Adil-Jussupov/Rheometer/Random files/IMG_4448.jpg

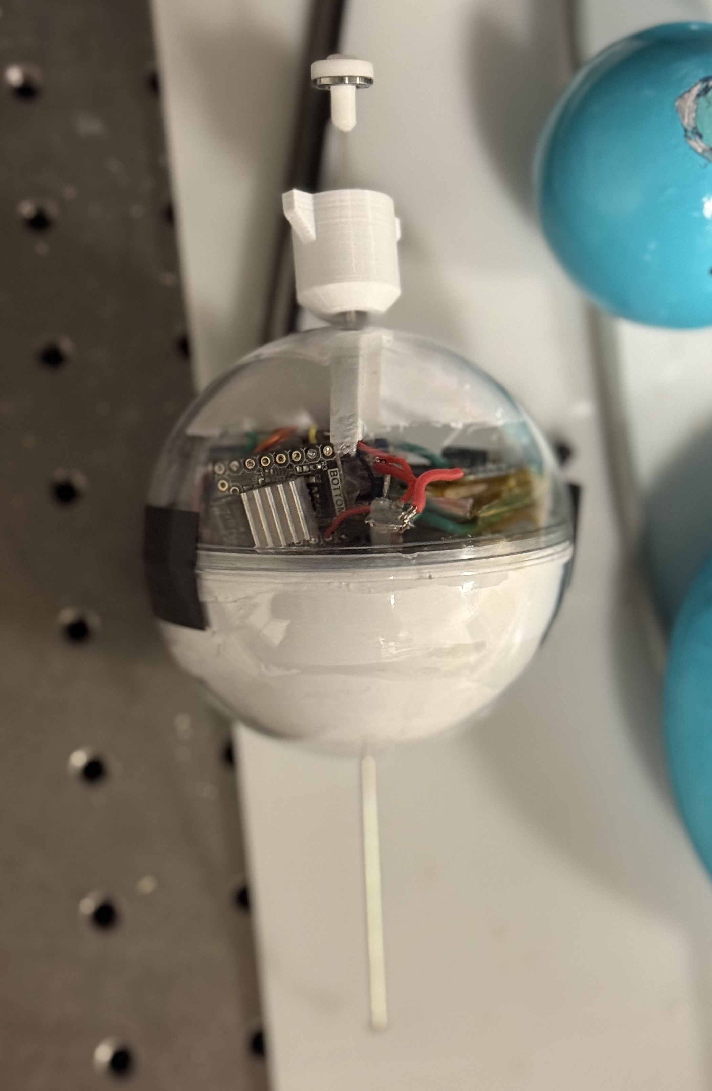
Random files/IMG_4448.jpg
