Adil-Jussupov/Rheometer/README.md

# Rheometer
Floating robot for measuring liquid properties
