Adil-Jussupov/Rheometer/LoadCell.pdf

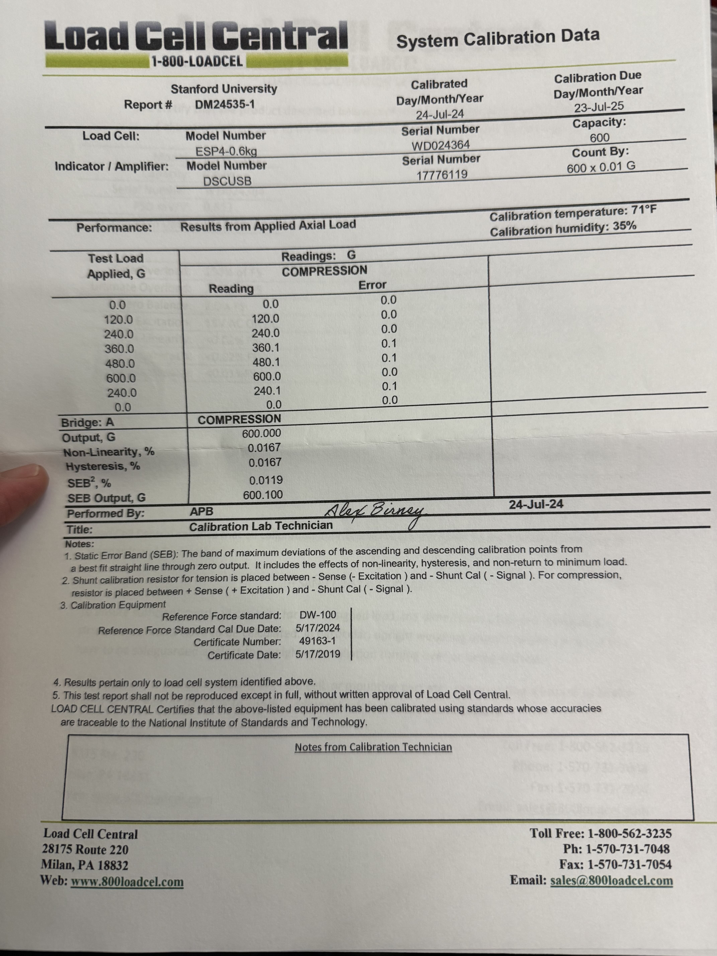
[picture p2: page 1]
