Adil-Jussupov/Rheometer/Patent/S24-388-PROV-Jussupov-AID233-IID8017_signed.pdf

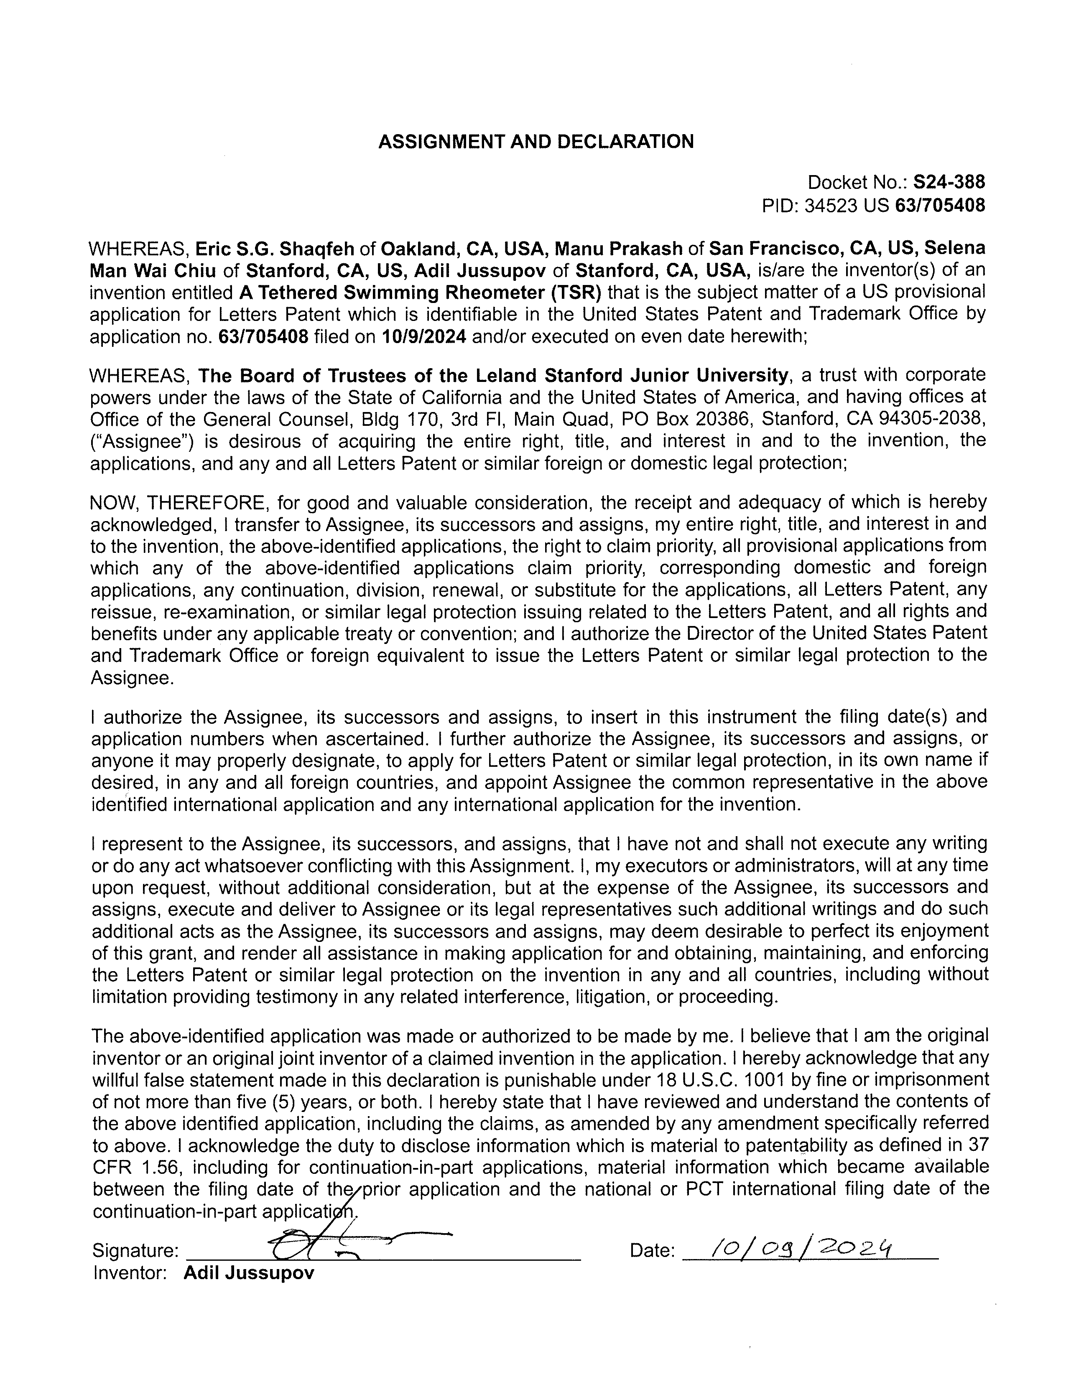
[picture p12: page 1]
