Adil-Jussupov/Rheometer/Case/STL/Pancake_motor.jpeg

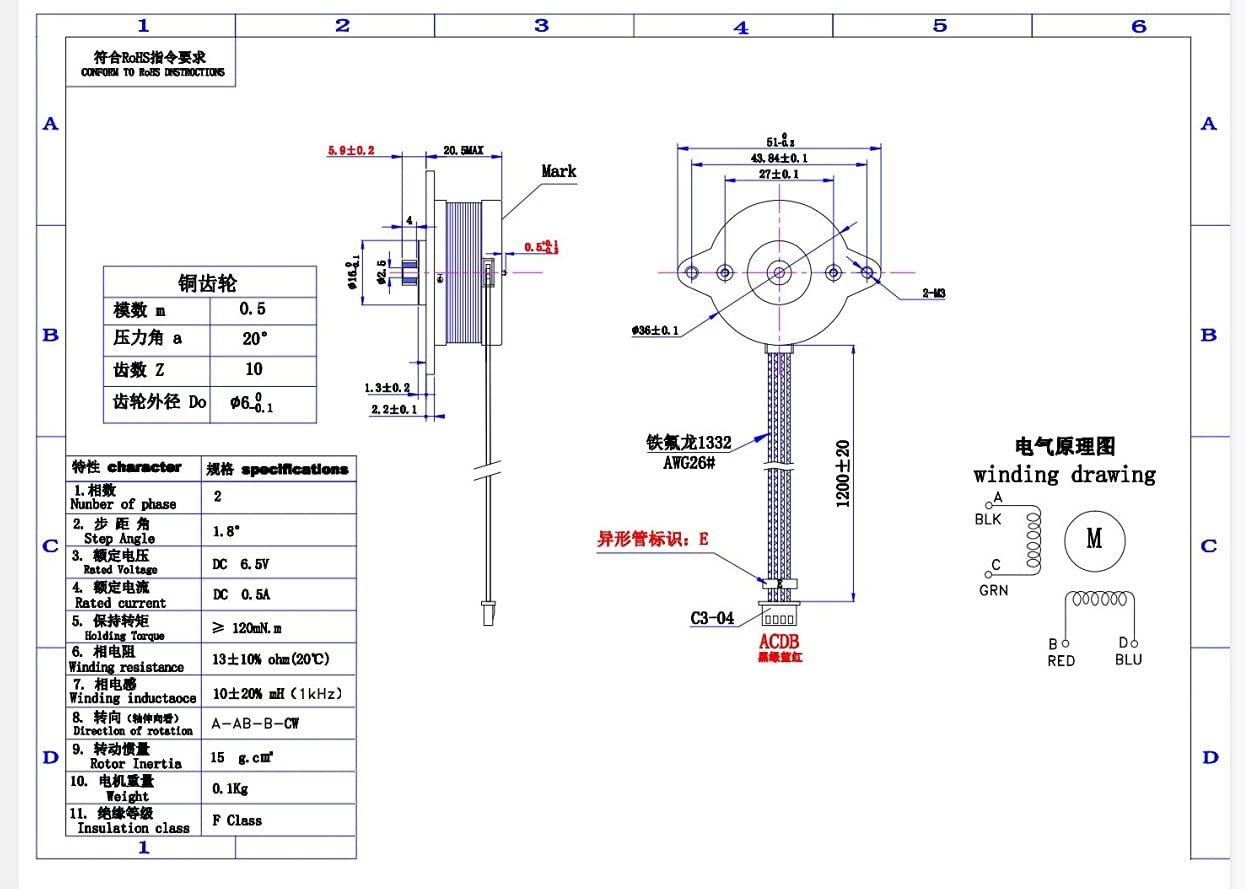
Case/STL/Pancake_motor.jpeg
