Adil-Jussupov/Rheometer/Case/Geared_DC_Motor.SLDPRT

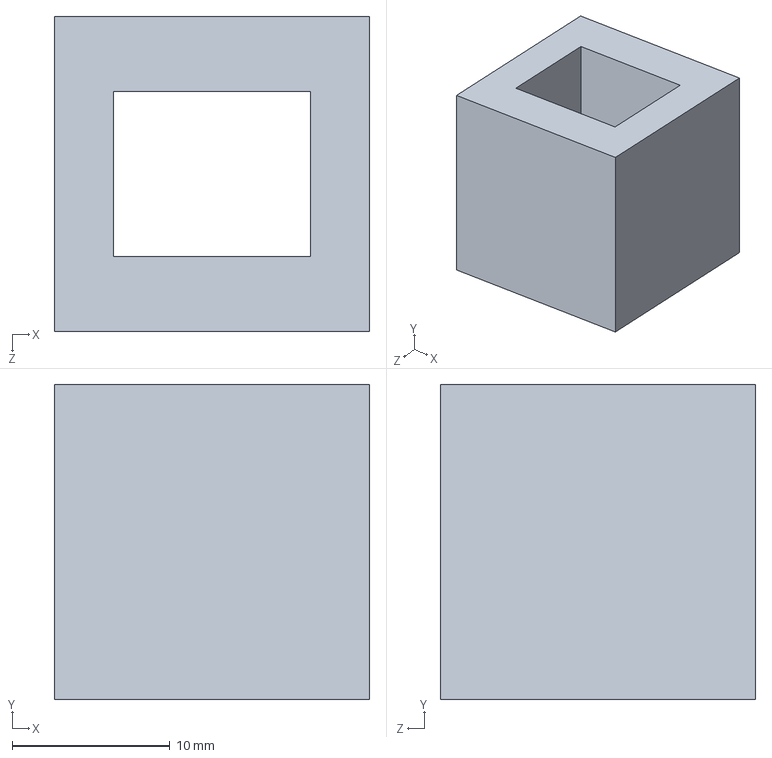
[picture p14: CAD file, 2025-04-24]
Case/Geared_DC_Motor.SLDPRT
20.0 x 20.0 x 20.0 mm
