Adil-Jussupov/Rheometer/Case/Geared_DC_Motor/Geared_DC_Motor_frame.SLDPRT

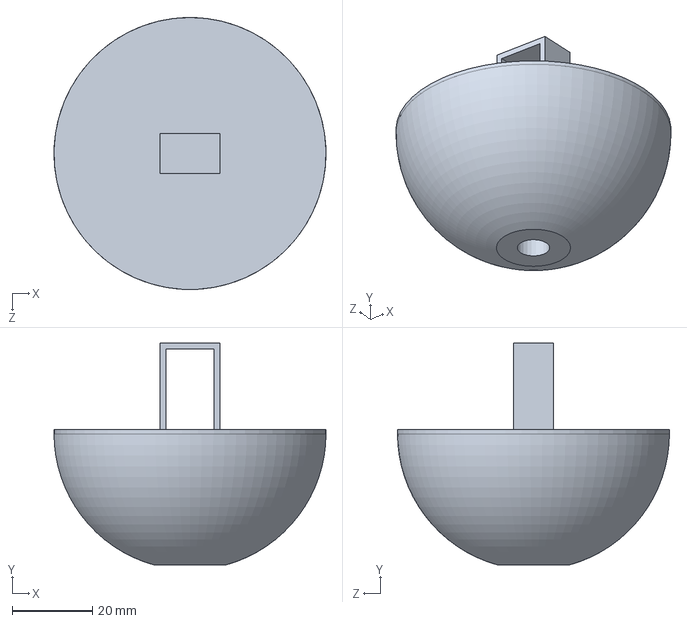
[picture p15: CAD file, 2025-04-24]
Case/Geared_DC_Motor/Geared_DC_Motor_frame.SLDPRT
67.6 x 55.1 x 67.6 mm
