Adil-Jussupov/Rheometer/Case/Motor_up_ESP32_board/Motor_interface_frame.SLDPRT

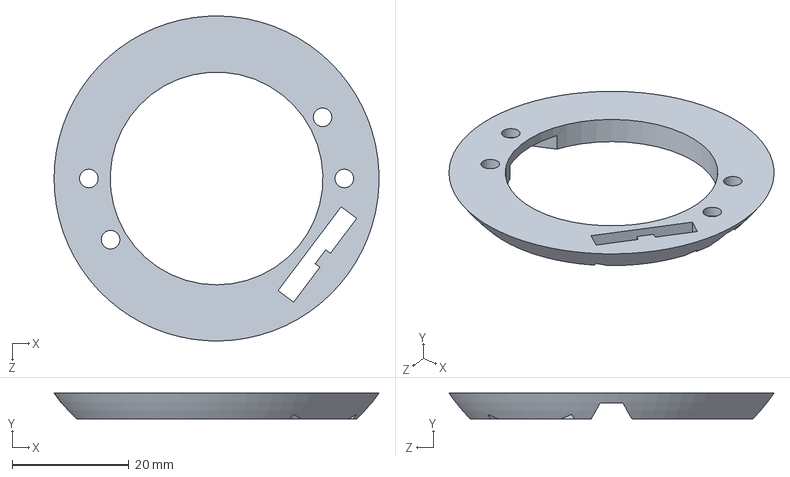
[picture p16: CAD file, 2025-01-18]
Case/Motor_up_ESP32_board/Motor_interface_frame.SLDPRT
55.7 x 4.40 x 55.8 mm
