Adil-Jussupov/Rheometer/Case/MotorUp/Motor_frame.SLDPRT

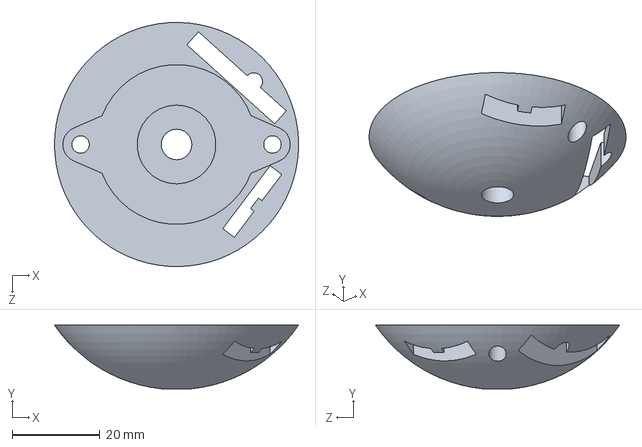
[picture p17: CAD file, 2025-03-20]
Case/MotorUp/Motor_frame.SLDPRT
55.7 x 14.5 x 55.8 mm
