Adil-Jussupov/Rheometer/Case/Tails/Tail-(0.5-0.75)_2_pieces.STEP

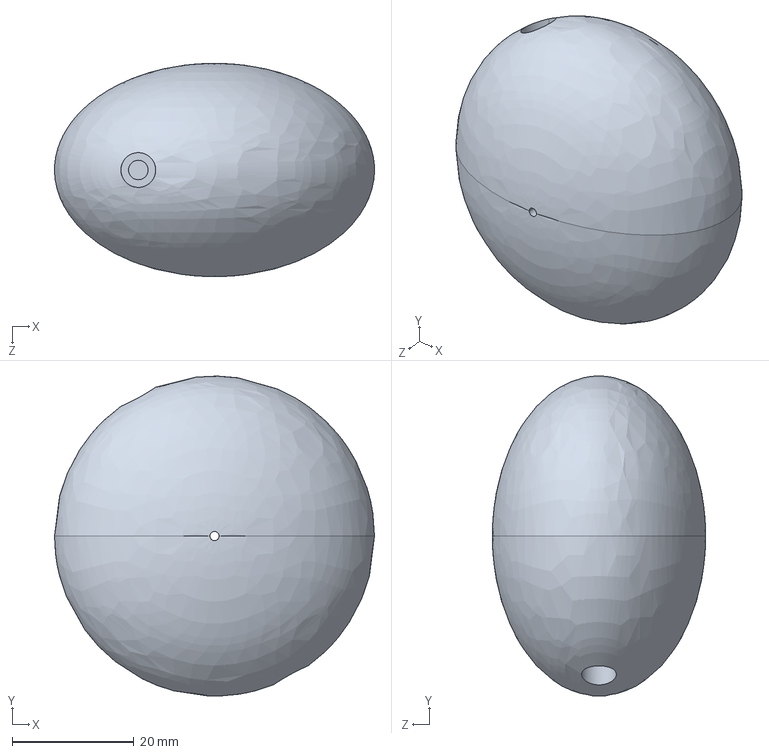
[picture p18: CAD file, 2025-01-28]
Case/Tails/Tail-(0.5-0.75)_2_pieces.STEP
52.5 x 52.5 x 35.0 mm
