Adil-Jussupov/Rheometer/Case/Collet_motor.SLDPRT

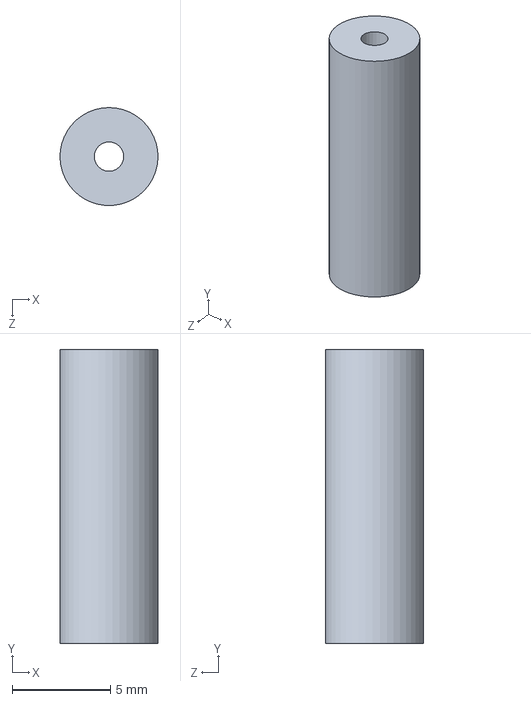
[picture p19: CAD file, 2025-04-24]
Case/Collet_motor.SLDPRT
5.00 x 15.0 x 4.99 mm
