Adil-Jussupov/Rheometer/Case/Geared_DC_Motor/Collet_motor.SLDPRT

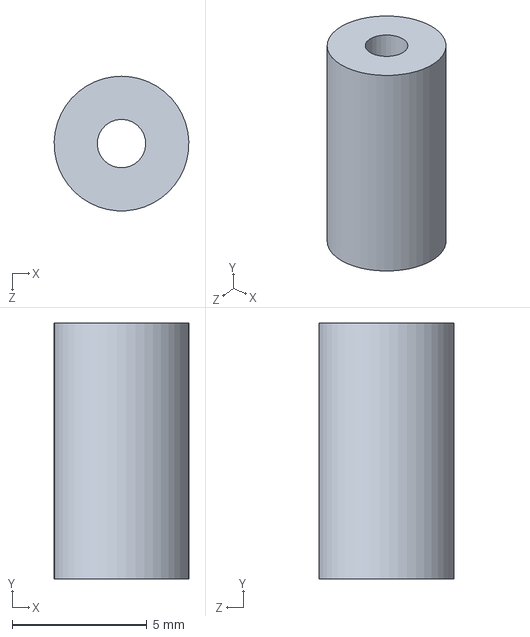
[picture p20: CAD file, 2025-01-18]
Case/Geared_DC_Motor/Collet_motor.SLDPRT
5.00 x 9.50 x 4.99 mm
