Adil-Jussupov/Rheometer/Case/Motor_up_ESP32_board/Motor_frame.SLDPRT

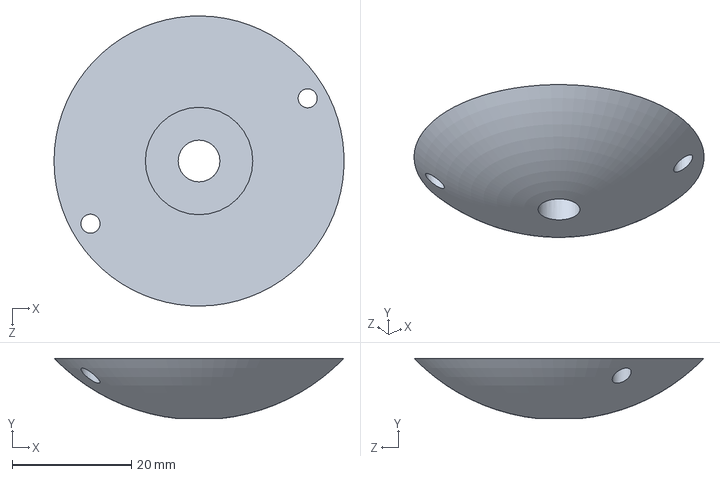
[picture p21: CAD file, 2025-01-18]
Case/Motor_up_ESP32_board/Motor_frame.SLDPRT
48.6 x 10.1 x 48.6 mm
