Adil-Jussupov/Rheometer/Case/MotorUp/Ball_center_drill.SLDPRT

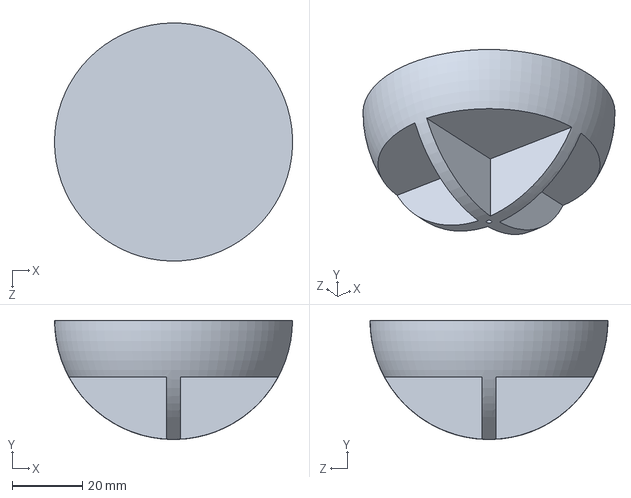
[picture p22: CAD file, 2025-03-20]
Case/MotorUp/Ball_center_drill.SLDPRT
67.6 x 33.8 x 67.6 mm
