Adil-Jussupov/Rheometer/Case/STL/Motor_frame_bottom.3MF

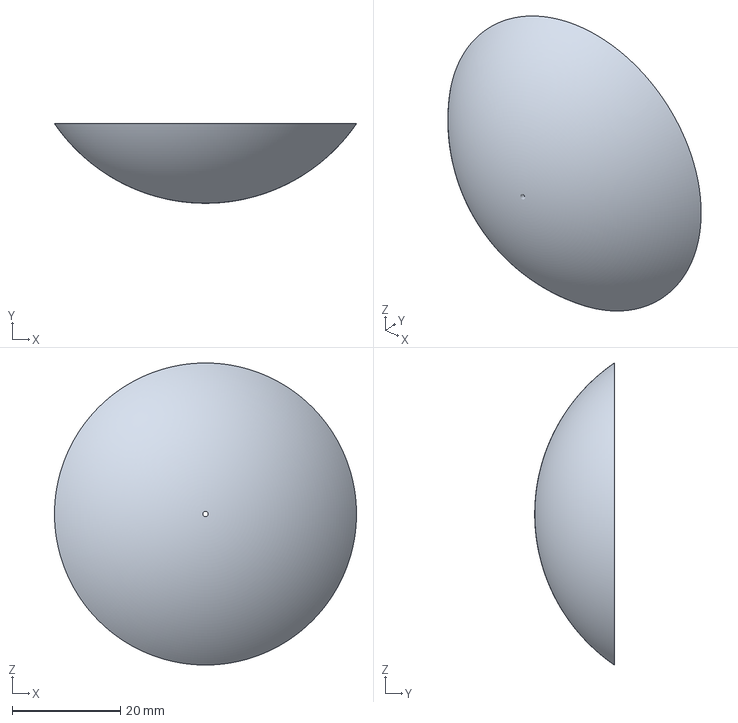
[picture p23: CAD file, 2025-03-20]
Case/STL/Motor_frame_bottom.3MF
55.8 x 14.7 x 55.8 mm
