Adil-Jussupov/Rheometer/Case/Tails/direct_head_uti_sork_ex_final.stp.SLDPRT

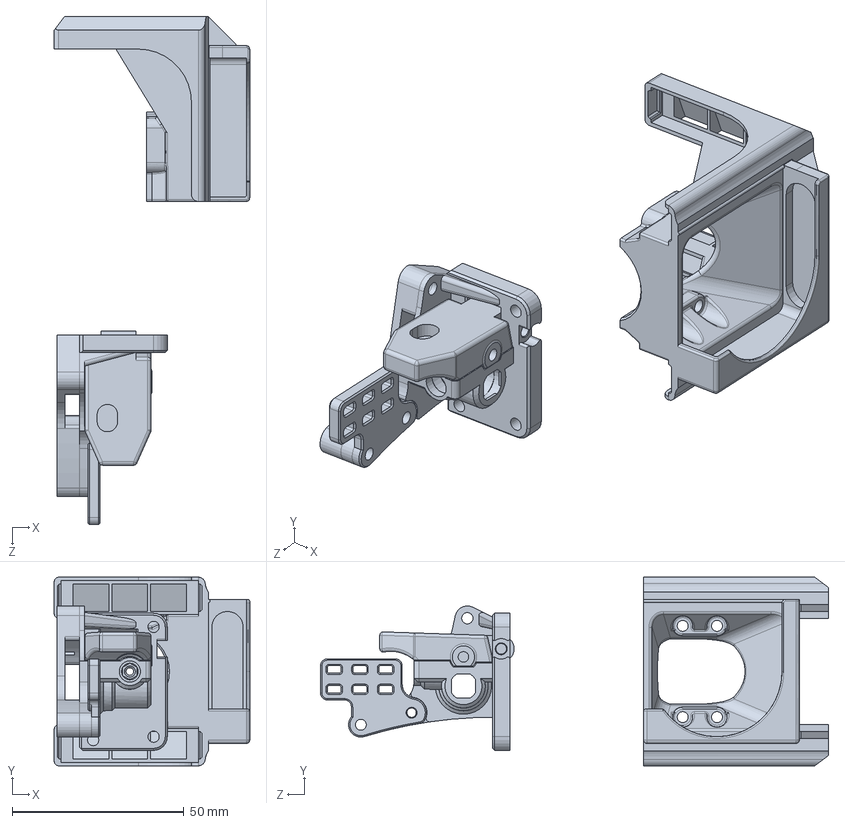
[picture p24: CAD file, 2025-01-28]
Case/Tails/direct_head_uti_sork_ex_final.stp.SLDPRT
57.0 x 55.0 x 148.1 mm
