Adil-Jussupov/Rheometer/Case/Ball_center.SLDPRT

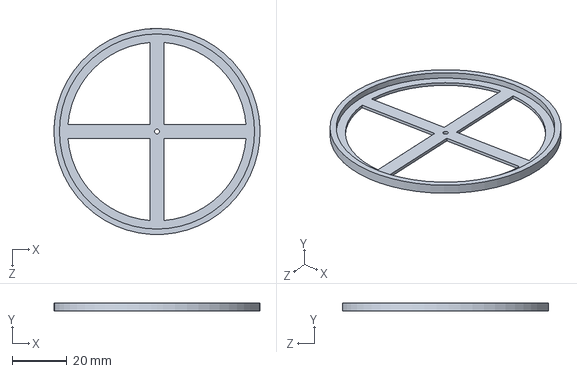
[picture p25: CAD file, 2025-01-28]
Case/Ball_center.SLDPRT
75.0 x 3.00 x 75.0 mm
