Adil-Jussupov/Rheometer/Case/MotorUp/Motor_frame_solid.SLDPRT

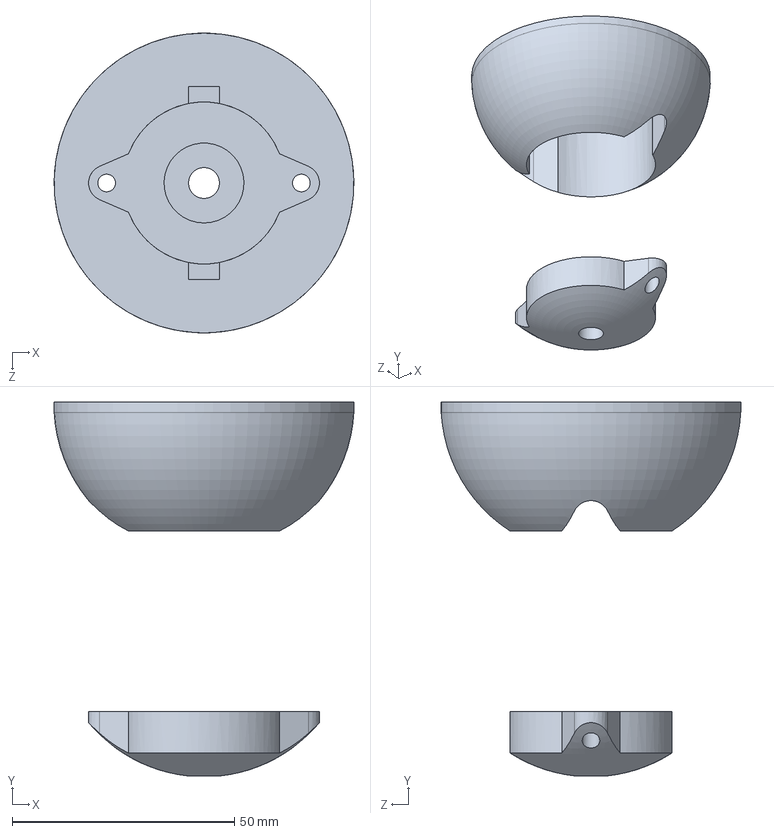
[picture p26: CAD file, 2025-03-20]
Case/MotorUp/Motor_frame_solid.SLDPRT
67.5 x 84.2 x 67.5 mm
