Adil-Jussupov/Rheometer/Case/STL/Ball_center_drill.3MF

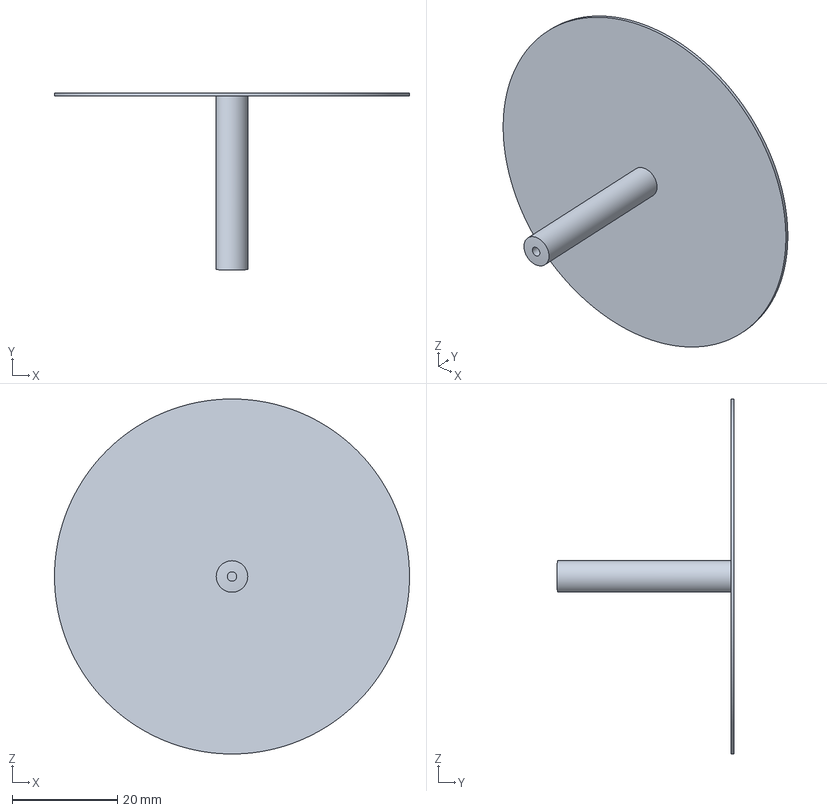
[picture p27: CAD file, 2025-03-20]
Case/STL/Ball_center_drill.3MF
67.6 x 33.8 x 67.6 mm
