Adil-Jussupov/Rheometer/Case/Tails/Tail-Spheroid(0.5-1.5).SLDPRT

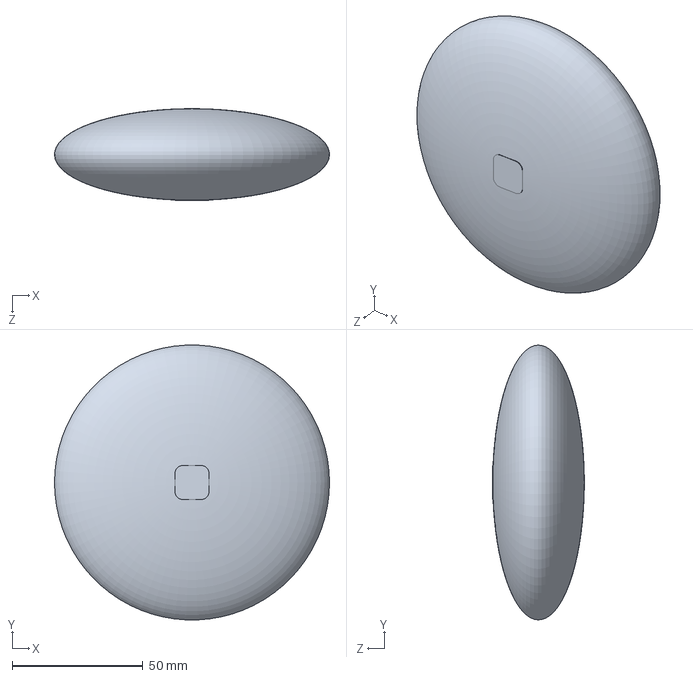
[picture p28: CAD file, 2024-11-22]
Case/Tails/Tail-Spheroid(0.5-1.5).SLDPRT
105.0 x 104.9 x 35.0 mm
