Adil-Jussupov/Rheometer/Case/Motor_up_ESP32_board/Motor_frame_base.SLDPRT

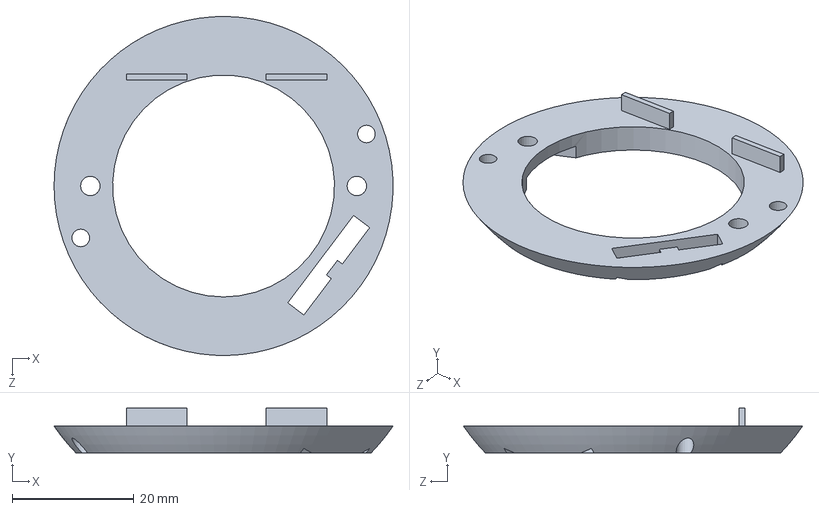
[picture p29: CAD file, 2025-01-18]
Case/Motor_up_ESP32_board/Motor_frame_base.SLDPRT
55.7 x 7.40 x 55.8 mm
