Adil-Jussupov/Rheometer/Case/Tails/Tail-Spheroid(0.5-0.75).SLDPRT

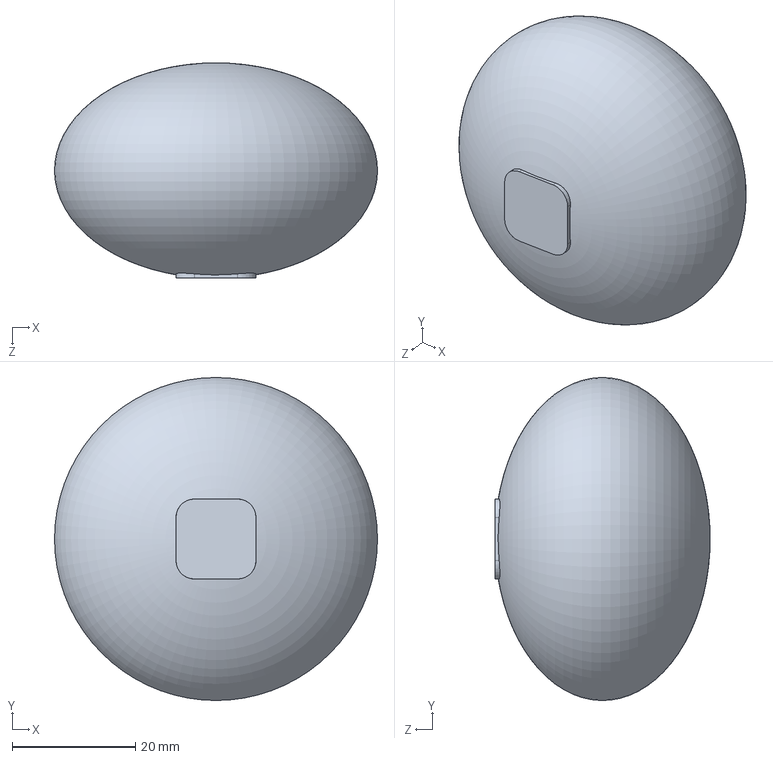
[picture p30: CAD file, 2024-11-22]
Case/Tails/Tail-Spheroid(0.5-0.75).SLDPRT
52.5 x 52.5 x 35.0 mm
