Adil-Jussupov/Rheometer/Case/Cylinder_bearing_test.SLDPRT

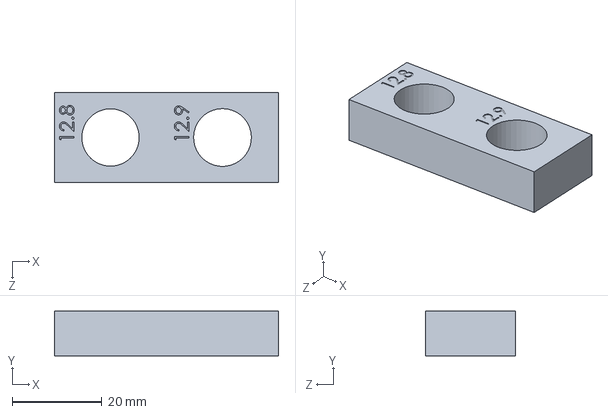
[picture p31: CAD file, 2024-11-22]
Case/Cylinder_bearing_test.SLDPRT
50.0 x 10.0 x 20.0 mm
