Adil-Jussupov/Rheometer/Case/MotorUp/Collet_holder.SLDPRT

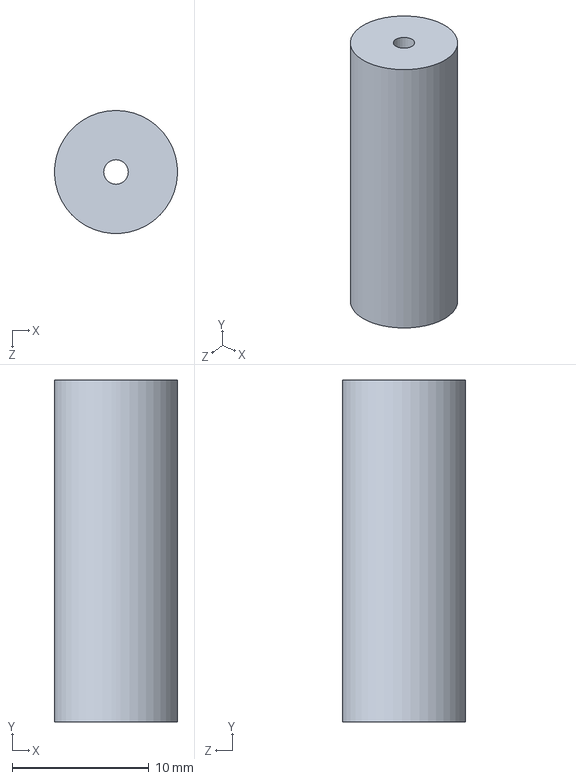
[picture p32: CAD file, 2025-01-18]
Case/MotorUp/Collet_holder.SLDPRT
8.99 x 25.0 x 9.00 mm
