Adil-Jussupov/Rheometer/Case/STL/Ball_center_drill-1.3MF

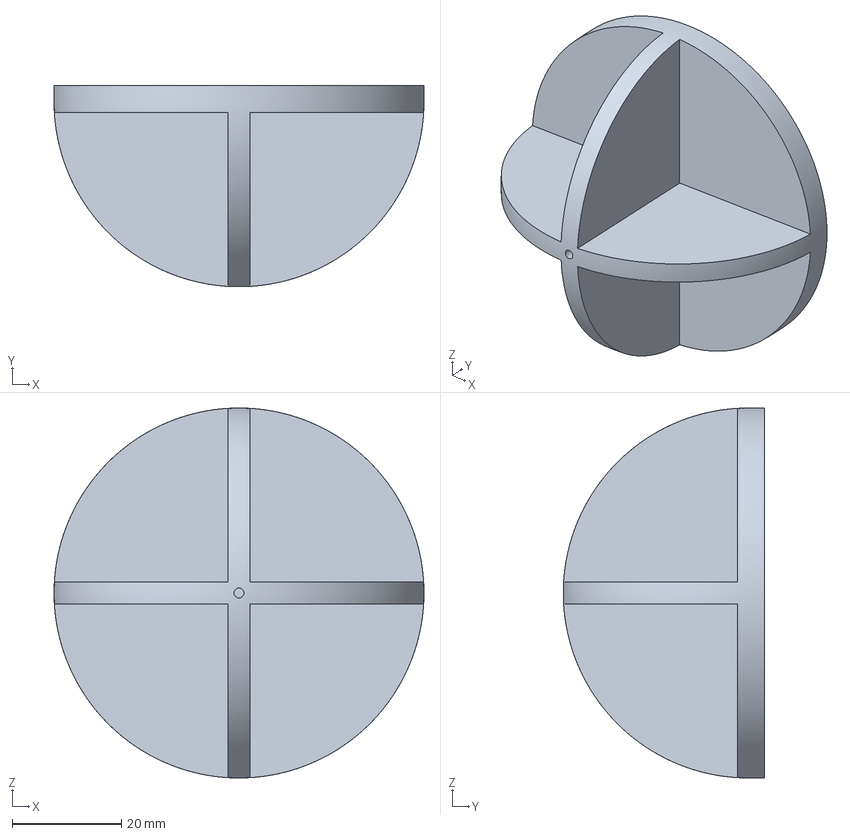
[picture p33: CAD file, 2025-03-20]
Case/STL/Ball_center_drill-1.3MF
67.6 x 36.8 x 67.6 mm
