Adil-Jussupov/Rheometer/Case/Tails/8.STL

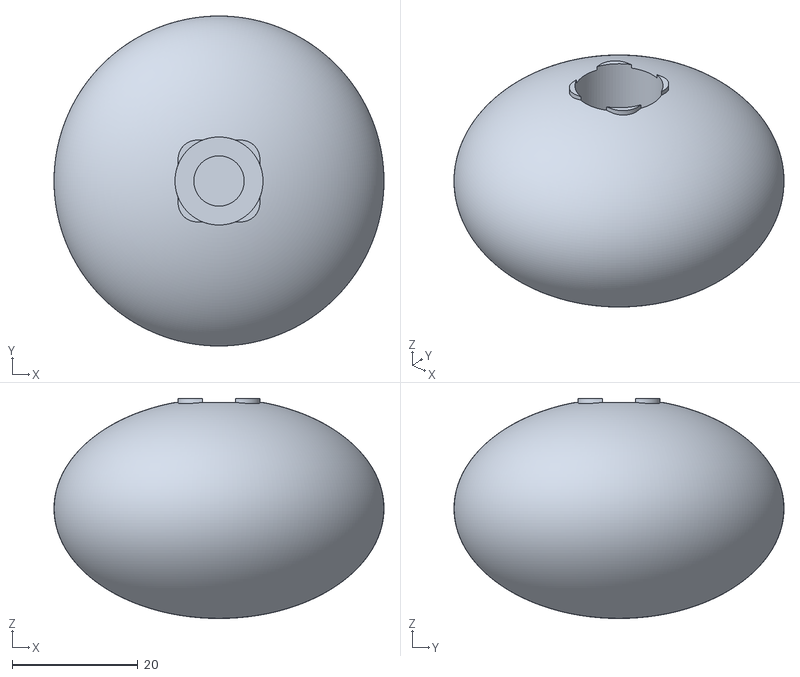
[picture p34: CAD file, 2024-10-31]
Case/Tails/8.STL
52.5 x 52.5 x 35.0
