Adil-Jussupov/Rheometer/Case/Dremmel_moving_part.SLDPRT

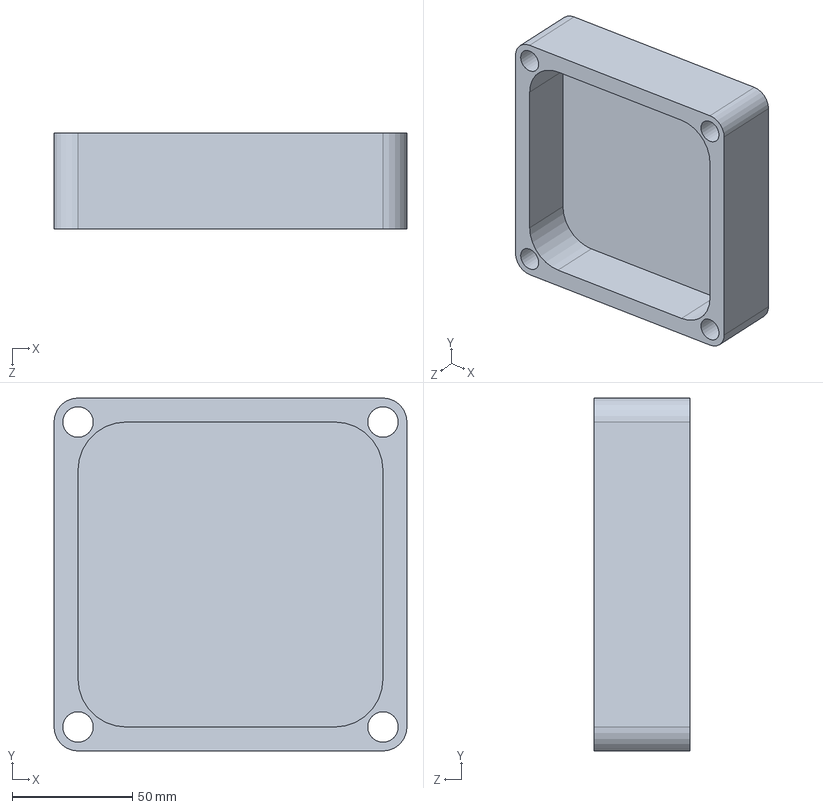
[picture p35: CAD file, 2024-11-22]
Case/Dremmel_moving_part.SLDPRT
147.0 x 147.0 x 40.0 mm
