Adil-Jussupov/Rheometer/Case/Tail-(0.5-0.75)-w-hole.SLDPRT

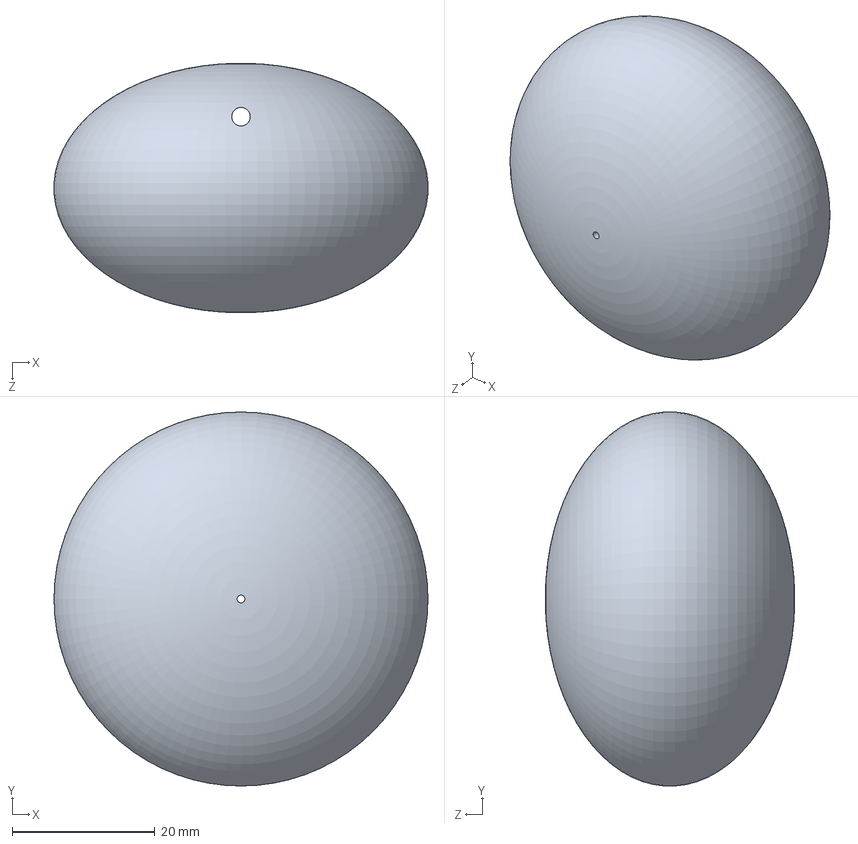
[picture p36: CAD file, 2024-11-22]
Case/Tail-(0.5-0.75)-w-hole.SLDPRT
52.5 x 52.5 x 35.0 mm
