Adil-Jussupov/Rheometer/Case/Motor_frame.SLDPRT

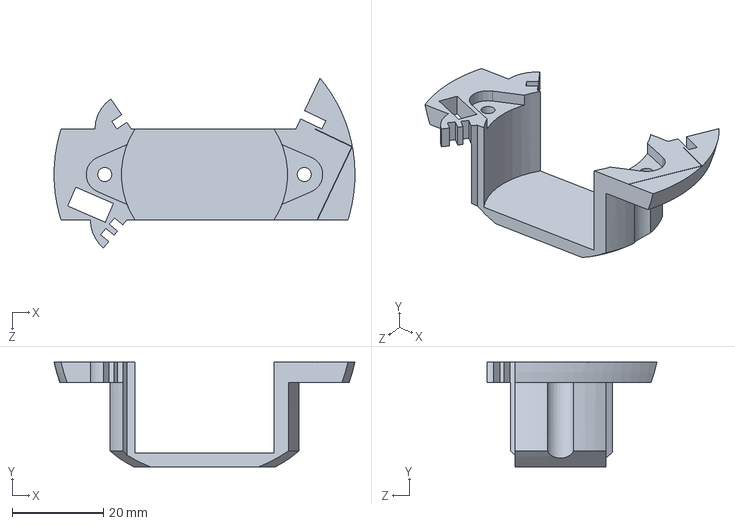
[picture p37: CAD file, 2024-11-22]
Case/Motor_frame.SLDPRT
66.1 x 23.0 x 37.3 mm
