Adil-Jussupov/Rheometer/Case/STL/Ball_center_drill-2.3MF

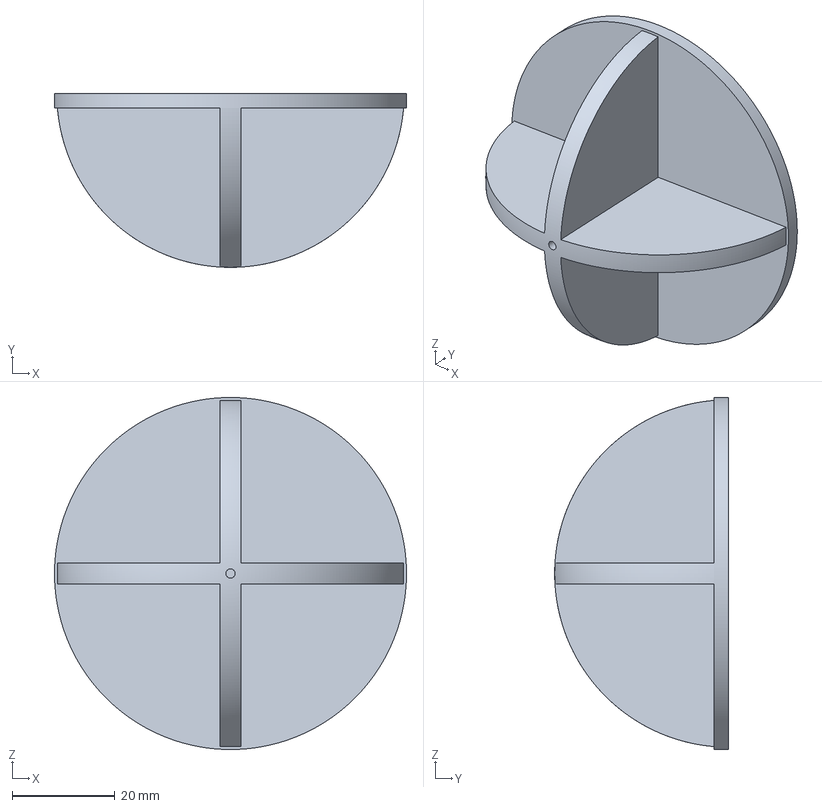
[picture p38: CAD file, 2025-03-20]
Case/STL/Ball_center_drill-2.3MF
68.5 x 33.8 x 68.5 mm
