Adil-Jussupov/Rheometer/Case/STL/helix on rod_L10_D24_d5_45_1.STL

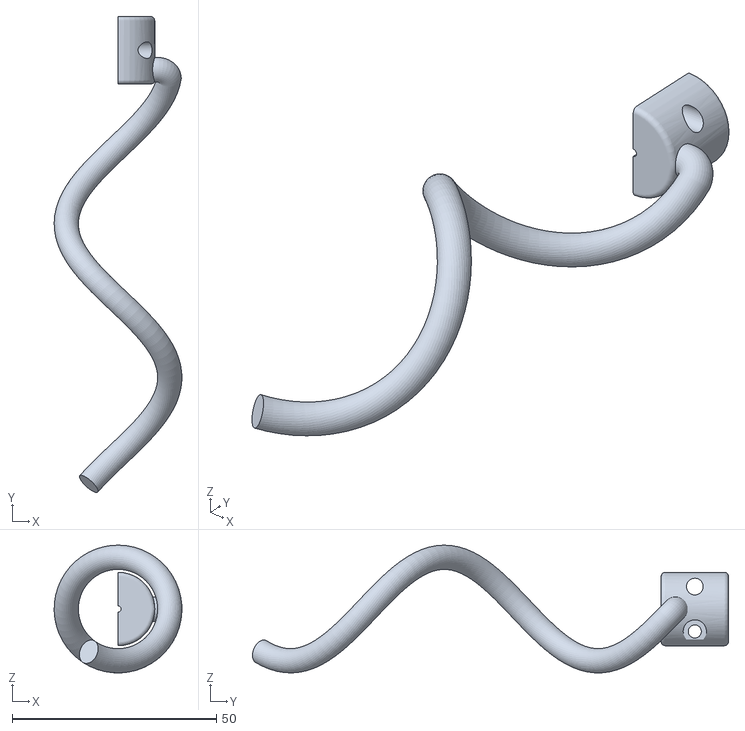
[picture p39: CAD file, 2025-01-28]
Case/STL/helix on rod_L10_D24_d5_45_1.STL
31.3 x 116.6 x 31.3
