Adil-Jussupov/Rheometer/Case/STL/helix fixture_L10_D24_d5_45_1.STL

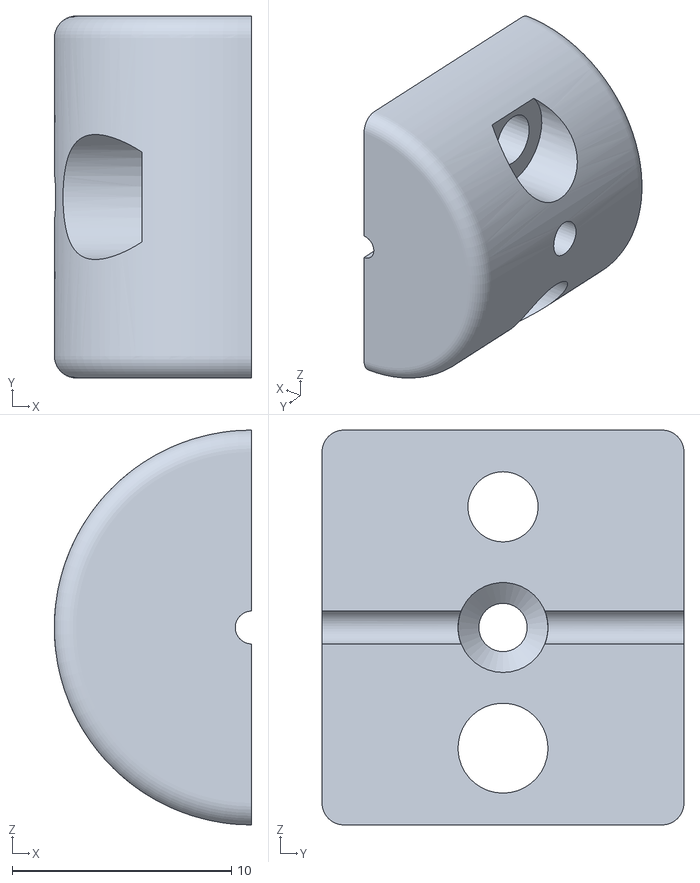
[picture p40: CAD file, 2025-01-28]
Case/STL/helix fixture_L10_D24_d5_45_1.STL
9.00 x 16.5 x 18.0
