Adil-Jussupov/Rheometer/Case/Toolholder_longer.SLDPRT

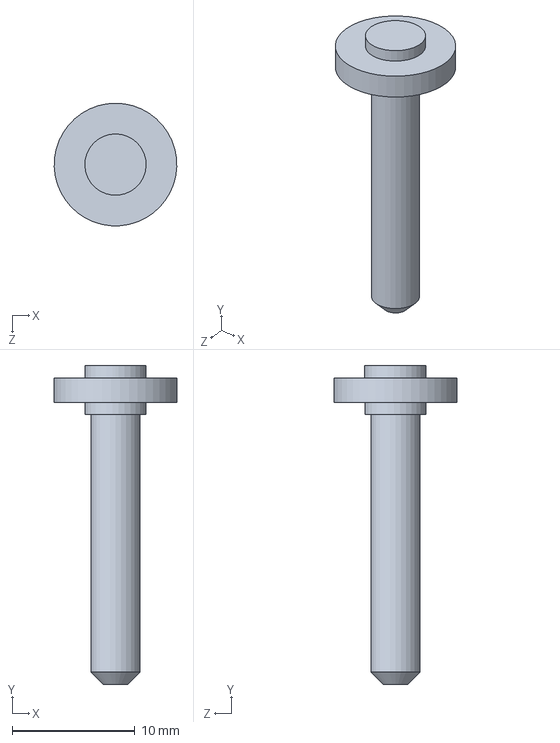
[picture p41: CAD file, 2024-10-31]
Case/Toolholder_longer.SLDPRT
9.99 x 26.0 x 9.99 mm
