Adil-Jussupov/Rheometer/Case/Top_tube_frame.SLDPRT

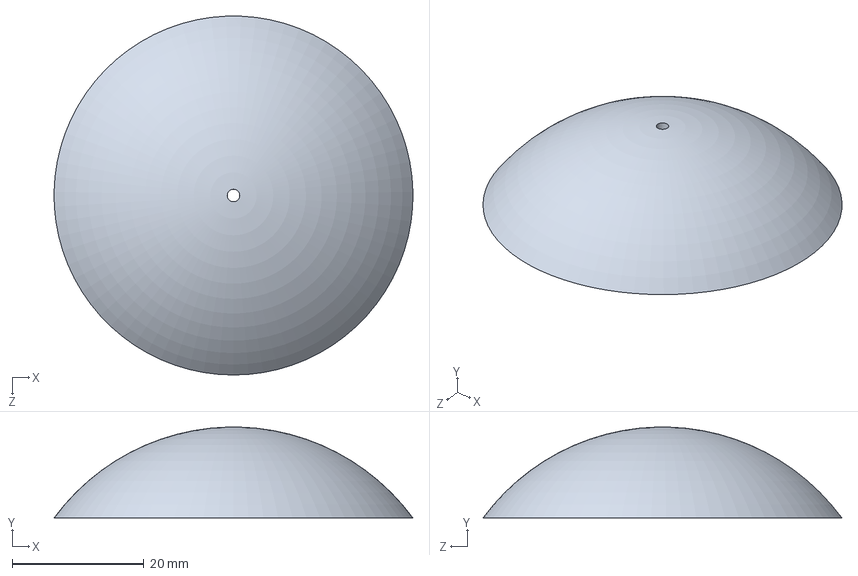
[picture p42: CAD file, 2024-10-31]
Case/Top_tube_frame.SLDPRT
54.5 x 13.8 x 54.5 mm
