Adil-Jussupov/Rheometer/Case/Hook_Loadcell v2.SLDPRT

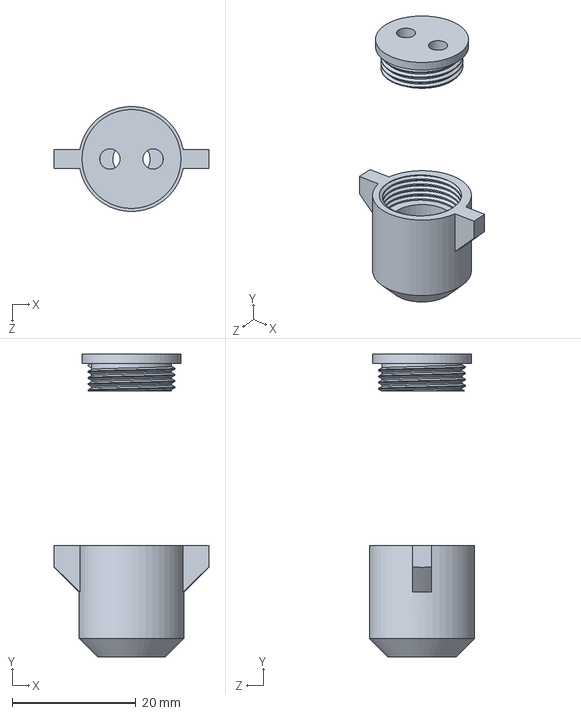
[picture p43: CAD file, 2024-10-31]
Case/Hook_Loadcell v2.SLDPRT
25.0 x 49.0 x 17.0 mm
