Adil-Jussupov/Rheometer/Case/Collet_holder.SLDPRT

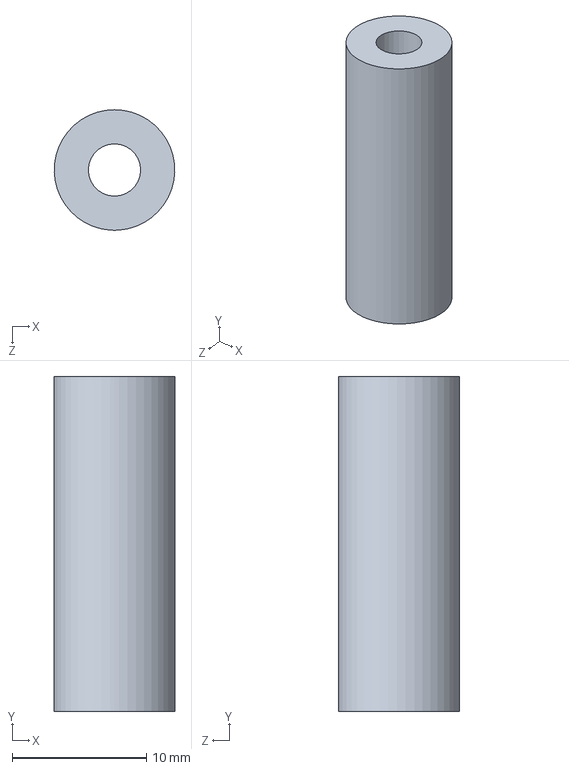
[picture p44: CAD file, 2024-10-31]
Case/Collet_holder.SLDPRT
8.99 x 25.0 x 9.00 mm
