Adil-Jussupov/Rheometer/Case/STL/Motor_frame_stand.3MF

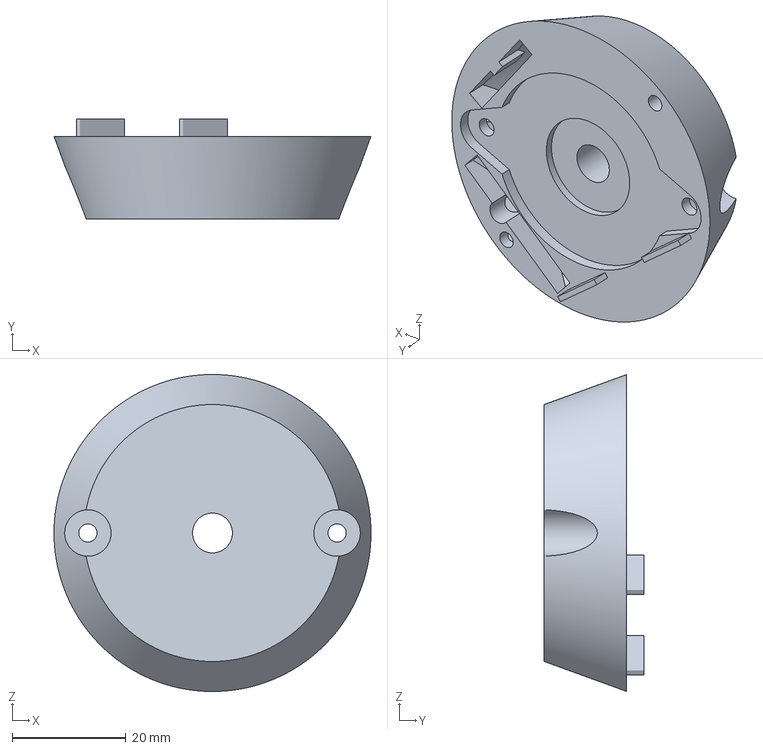
[picture p45: CAD file, 2025-01-18]
Case/STL/Motor_frame_stand.3MF
55.8 x 17.5 x 55.8 mm
