Adil-Jussupov/Rheometer/Case/STL/Collet_motor_1.6.3MF

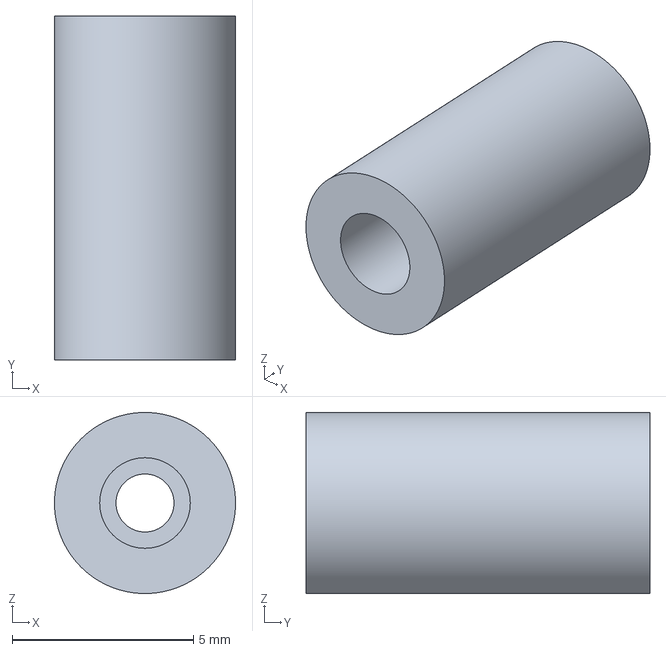
[picture p46: CAD file, 2025-01-18]
Case/STL/Collet_motor_1.6.3MF
5.00 x 9.50 x 5.00 mm
