Adil-Jussupov/Rheometer/Case/Top_bearinig_frame.SLDPRT

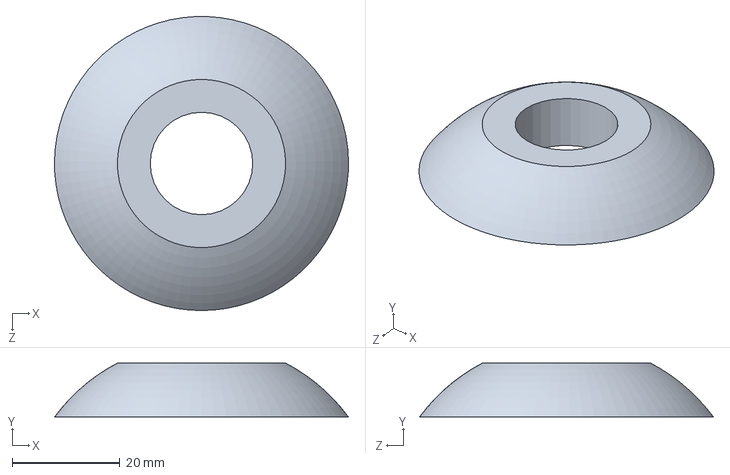
[picture p47: CAD file, 2024-10-03]
Case/Top_bearinig_frame.SLDPRT
54.5 x 10.0 x 54.5 mm
