Adil-Jussupov/Rheometer/Case/Magnet_case.SLDPRT

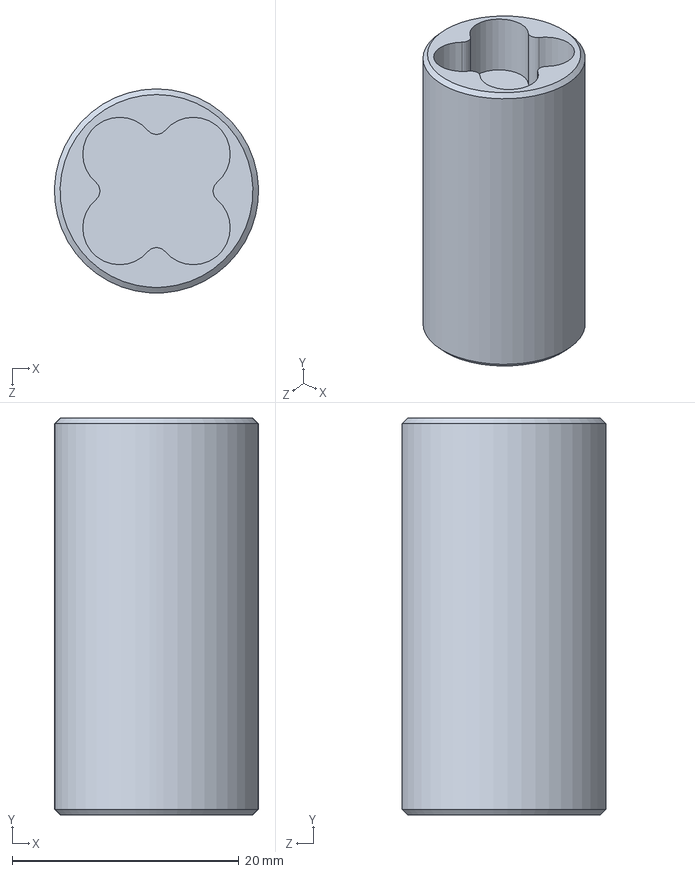
[picture p48: CAD file, 2024-09-18]
Case/Magnet_case.SLDPRT
18.0 x 35.0 x 18.0 mm
