Adil-Jussupov/Rheometer/Case/Hook.SLDPRT

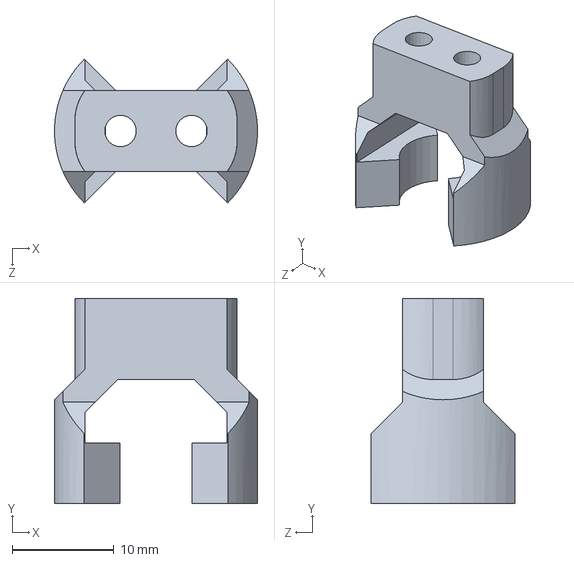
[picture p49: CAD file, 2024-08-16]
Case/Hook.SLDPRT
20.0 x 20.2 x 14.1 mm
