Adil-Jussupov/Rheometer/Case/Water_tank_hold.SLDPRT

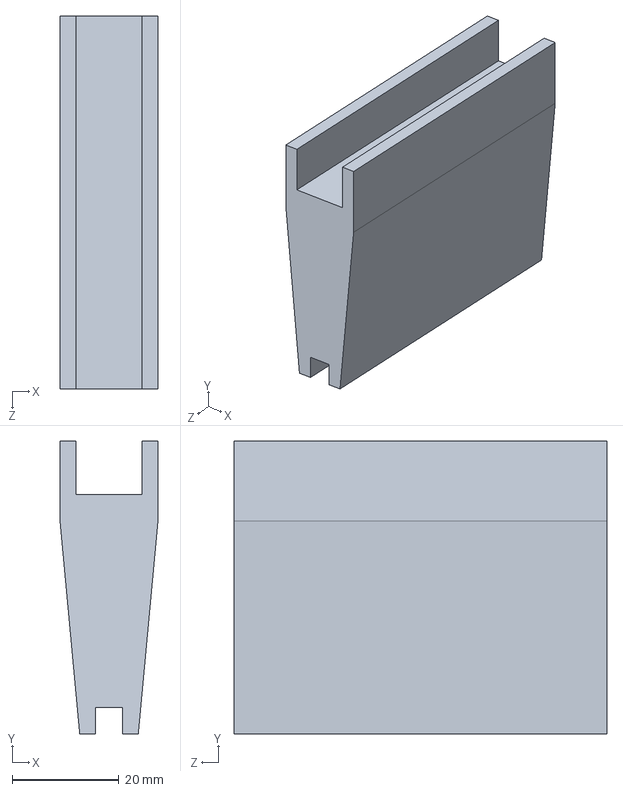
[picture p50: CAD file, 2024-08-15]
Case/Water_tank_hold.SLDPRT
18.4 x 55.0 x 70.0 mm
