Adil-Jussupov/Rheometer/Case/STL/Collet_motor_2.6_0.7.3MF

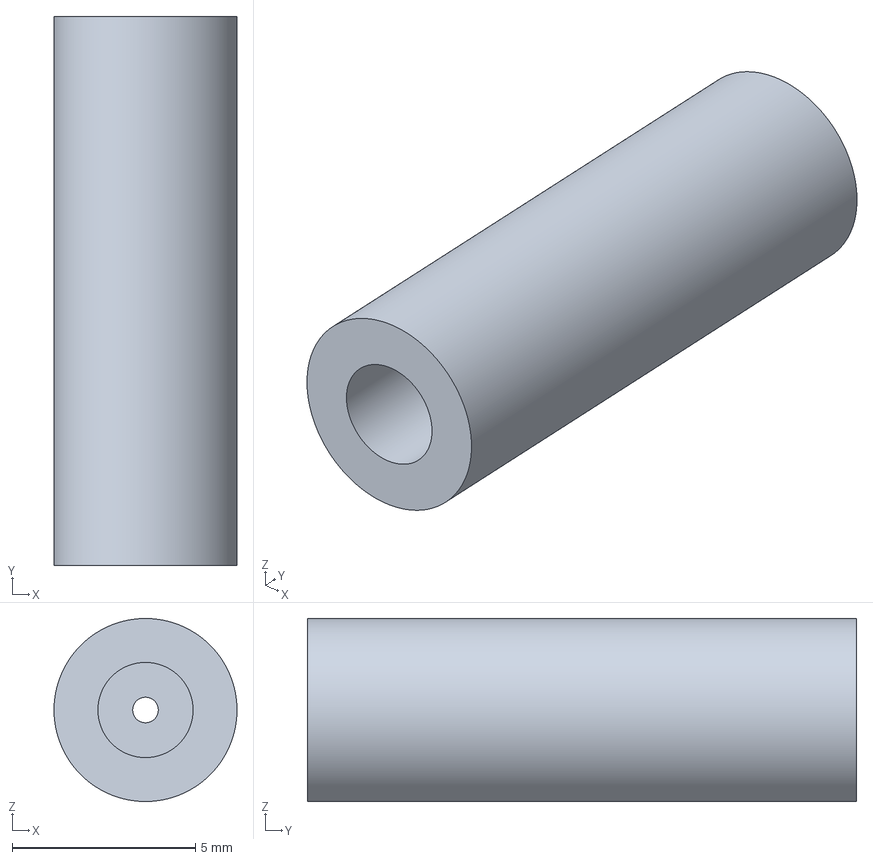
[picture p52: CAD file, 2024-11-22]
Case/STL/Collet_motor_2.6_0.7.3MF
5.00 x 15.0 x 5.00 mm
