Adil-Jussupov/Rheometer/Case/STL/Collet_motor_1.3MF

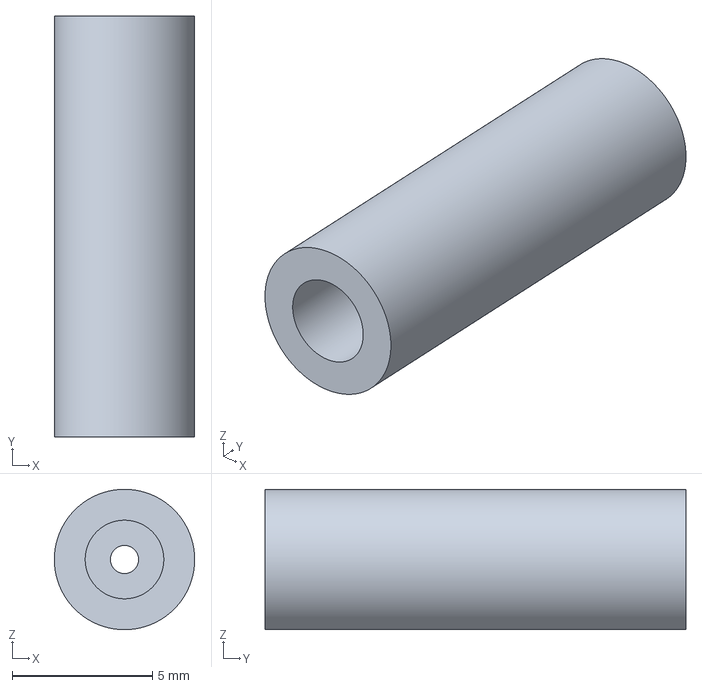
[picture p53: CAD file, 2024-11-22]
Case/STL/Collet_motor_1.3MF
5.00 x 15.0 x 5.00 mm
