Adil-Jussupov/Rheometer/Case/STL/prostavka-2.3MF

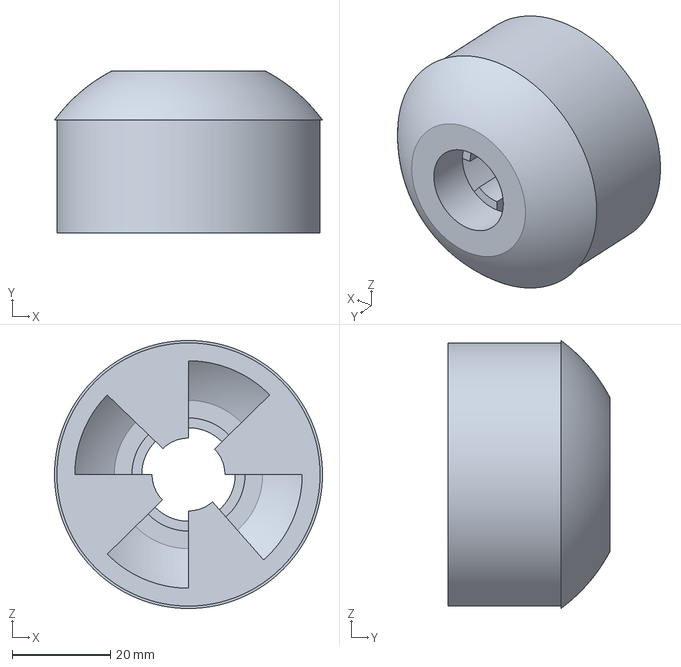
[picture p54: CAD file, 2024-10-03]
Case/STL/prostavka-2.3MF
54.5 x 33.0 x 54.5 mm
