Adil-Jussupov/Rheometer/Case/STL/prostavka.3MF

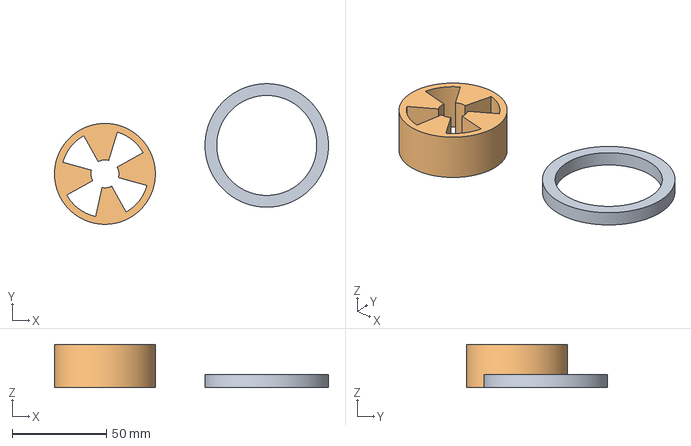
[picture p55: CAD file, 2024-10-03]
Case/STL/prostavka.3MF
145.3 x 74.6 x 23.0 mm
