Adil-Jussupov/Rheometer/Case/Motor_up_ESP32_board/Rheometer_big_pancake.SLDASM

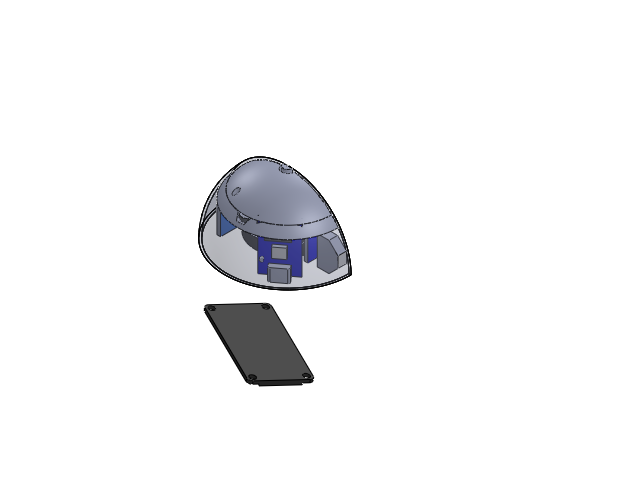
[picture p56: CAD file, 2025-01-18]
Case/Motor_up_ESP32_board/Rheometer_big_pancake.SLDASM
Pancake_motor
Motor_interface_frame
Hemisphere_Shell
DC-DC_5-12
TP4056
TMC2208
Collet_motor
LiPo_1800
ESP32
Motor_frame
