Adil-Jussupov/Rheometer/Case/MotorUp/Rheometer_big_pancake.SLDASM

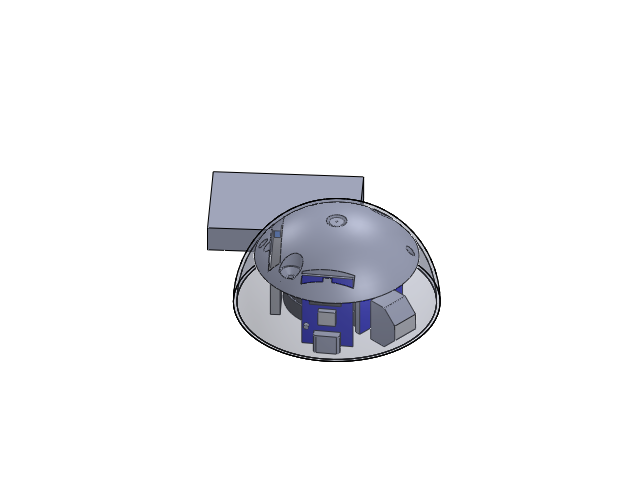
[picture p57: CAD file, 2025-01-18]
Case/MotorUp/Rheometer_big_pancake.SLDASM
Pancake_motor
Motor_frame
Hemisphere_Shell
DC-DC_5-12
TP4056
TMC2208
Collet_motor
ESP32_Chip
LiPo_1800
