Adil-Jussupov/Rheometer/Case/Rheometer_big_pancake.SLDASM

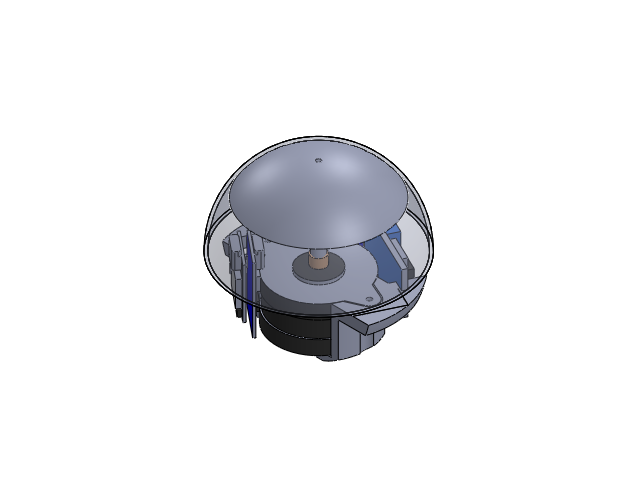
[picture p58: CAD file, 2024-11-22]
Case/Rheometer_big_pancake.SLDASM
Pancake_motor
Motor_frame
Hemisphere_Shell
DC-DC_5-12
ESP32S3
TP4056
TMC2208
Collet_motor
Top_tube_frame
