Adil-Jussupov/Rheometer/(list of files, cad)

Other CAD files:
Case/STL/Geared_DC_Motor_frame.3MF
Case/MotorUp/Motor_frame_bottom.SLDPRT
Case/STL/Motor_frame_solid.3MF
Case/Tail-(0.5-0.75)_2_pieces.SLDPRT
Case/STL/Top_ball_center.3MF
Case/STL/Motor_frame_2-27.3MF
Case/Tail-Spheroid(0.5-0.75)-w-hole.SLDPRT
Case/STL/Collet_holder_1.2.3MF
Case/STL/Collet_holder_1.8.3MF
Case/STL/Collet_holder_1.7.3MF
Case/STL/Motor_interface_frame.3MF
Case/Toolholder.SLDPRT
Case/STL/Collet_motor_1.8.3MF
Case/STL/Ball_center_70.3MF
Case/STL/Collet_holder_1.6.3MF
Case/STL/Collet_motor_1.7.3MF
Case/STL/Collet_motor_2.5_0.8.3MF
Case/STL/Collet_motor_0.8.3MF
Case/STL/Collet_motor_2.4_0.8.3MF
Case/STL/Collet_motor_0.6.3MF
Case/STL/Collet_motor_2.5_0.7.3MF
Case/STL/Collet_motor_2.6_0.8.3MF
Case/STL/Magnet_case_print.3MF
Case/Hook_Loadcell.SLDPRT
Case/Old parts/02-Hooks.SLDPRT
Case/Old parts/Case-controller.SLDPRT
Case/Old parts/Case.SLDPRT
Case/Old parts/Hook_Loadcell.SLDPRT
Case/Old parts/Puley insert.SLDPRT
Case/STL/Ball_center.3MF
Case/STL/Collet_holder.3MF
Case/STL/Collet_motor.3MF
Case/STL/Hook_Loadcell v2.3MF
Case/STL/Hook_Loadcell.3MF
Case/STL/Motor_frame.3MF
Case/STL/Tail(0.5-0.75)-w-hole.3MF
Case/STL/Tail-(0.5-0.75)_2_pieces.3MF
Case/STL/Toolholder.STL
Case/STL/Toolholder_longer.3MF
Case/STL/Top_bearinig_frame.3MF
Case/STL/Top_tube_frame.3MF
Case/STL/Water_tank_hold.3MF
Case/Standard parts/DC-DC_5-12.SLDPRT
Case/Standard parts/DS_display.SLDPRT
Case/Standard parts/ESP32.SLDPRT
Case/Standard parts/ESP32S3.SLDPRT
Case/Standard parts/ESP32_Chip.SLDPRT
Case/Standard parts/Hemisphere_Shell.SLDPRT
Case/Standard parts/LiPo.SLDPRT
Case/Standard parts/LiPo_1800.SLDPRT
Case/Standard parts/Load_cell_100g.SLDPRT
Case/Standard parts/Pancake_motor.SLDPRT
Case/Standard parts/TMC2208.SLDPRT
Case/Standard parts/TP4056.SLDPRT
Case/Tails/Tail-Spheroid(0.5-0.75).STL
Case/Tails/Tail-Spheroid(0.5-1.5).3mf
Case/Tails/Tail-Spheroid(0.5-1.5).STL
