Adil-Jussupov/Rheometer/(commit log)

2024-07-17 Standart parts
    Found following standard parts:
    - Load-Cell ESP4-0.6
    - Hook universal joint
    - annual subscription for Parallels Pro Academic version
2024-08-15 Hook for the first version
    [Hook.SLDPRT, Water_tank_hold.3MF, Water_tank_hold.SLDPRT]
2024-08-16 New Hook
    Added new hook to connect new high definition load cell.
    [Hook.SLDPRT, Hook_Loadcell-1.3MF, Hook_Loadcell-2.3MF, Hook_Loadcell.SLDPRT]
2024-08-16 Gcode created
    [Hook_Loadcell-1.3MF]
2024-08-19 Made dimension adjustments for loadcell connector
    Printed and everithing works well
    [Hook_Loadcell-1.3MF, Hook_Loadcell-2.3MF, Hook_Loadcell.SLDPRT]
2024-08-28 Stepper motor control
    Sketch for controlling a stepper motor.
    - Change speed with serial input (doesn't work properly)
    [StepmotorControl.ino]
2024-08-28 Control stepper motor by RPM
2024-08-29 Control motor speed, direction via Serial input
2024-08-30 Stepper controller
    added moving to a desired number of steps
2024-09-06 controller app works with DRV8825 drivers
2024-09-18 Designed and printed rod for magnets. Sizes are adjusted for 4 cylinder magnets d=6, h=7
    [02-Hooks.SLDPRT, Case-controller.SLDPRT, Case.SLDPRT, DS_display.SLDPRT, Hemisphere_Shell.SLDPRT, Load_cell_100g.SLDPRT, Magnet_case.SLDPRT, Magnet_case_print.3MF]
2024-10-03 version with no universal joint
    [Hook_Loadcell-1.3MF, Hook_Loadcell-2.3MF, Hook_Loadcell.3MF, Hook_Loadcell.SLDPRT, Motor_frame.SLDPRT, Rheometer_big_pancake.SLDASM, Toolholder.SLDPRT, Toolholder.STL]
2024-10-31 New design started
    [8.STL, Collet_holder.3MF, Collet_holder.SLDPRT, Collet_motor.3MF, Collet_motor.SLDPRT, Hook_Loadcell v2.3MF, Hook_Loadcell v2.SLDPRT, Tail(0.5-0.75)-w-hole.3MF]
2024-11-04 Test cylinder bearing to drill precise 0.5 mm holes
    [Cylinder_bearing_test.3MF, Cylinder_bearing_test.SLDPRT]
2024-11-22 Added support of ios app.
    5 buttons in app (on/off, revers)
    [Collet_motor.3MF, Collet_motor.SLDPRT, Collet_motor_0.6.3MF, Collet_motor_0.8.3MF, Collet_motor_1.3MF, Collet_motor_2.4_0.7.3MF, Collet_motor_2.4_0.8.3MF, Collet_motor_2.5_0.7.3MF]
2025-01-18 New motor app
    [Ball_center.3MF, Ball_center.SLDPRT, Ball_center_70.3MF, Collet_holder.SLDPRT, Collet_holder_1.2.3MF, Collet_holder_1.6.3MF, Collet_holder_1.7.3MF, Collet_holder_1.8.3MF]
2025-01-28 Working software
    [Ball_center.3MF, Ball_center.SLDPRT, Tail-(0.5-0.75)_2_pieces.SLDPRT, Tail-(0.5-0.75)_2_pieces.STEP, direct_head_uti_sork_ex_final.stp.SLDPRT, helix fixture_L10_D24_d5_45_1.STL, helix on rod_L10_D24_d5_45_1.STL]
2025-03-20 Working robot
    issues:
    huge resonans
    [Ball_center_drill-1.3MF, Ball_center_drill-2.3MF, Ball_center_drill.3MF, Ball_center_drill.SLDPRT, Motor_frame.SLDPRT, Motor_frame_2-27.3MF, Motor_frame_bottom.3MF, Motor_frame_bottom.SLDPRT]
2025-04-24 Recent updates
    [Collet_motor.3MF, Collet_motor.SLDPRT, Geared_DC_Motor.SLDPRT, Geared_DC_Motor_frame.3MF, Geared_DC_Motor_frame.SLDPRT]
